hmhyau/EEE2037-FM-Radio-Project/Lab Project Report/Images/20170413_160736.jpg

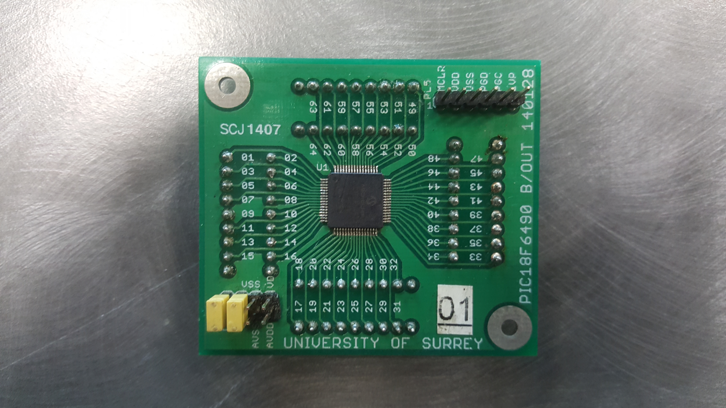
Lab Project Report/Images/20170413_160736.jpg
