hmhyau/EEE2037-FM-Radio-Project/README.md

# EEE2037-FM-Radio-Project
FM Radio Project code and report archives.
