hmhyau/EEE2037-FM-Radio-Project/Lab Project Report/Presentation.pptx

## LDPS IV FM Receiver Project

PENG YOUN TAN
TEDDY NG
HERMAN YAU

## Gantt Chart

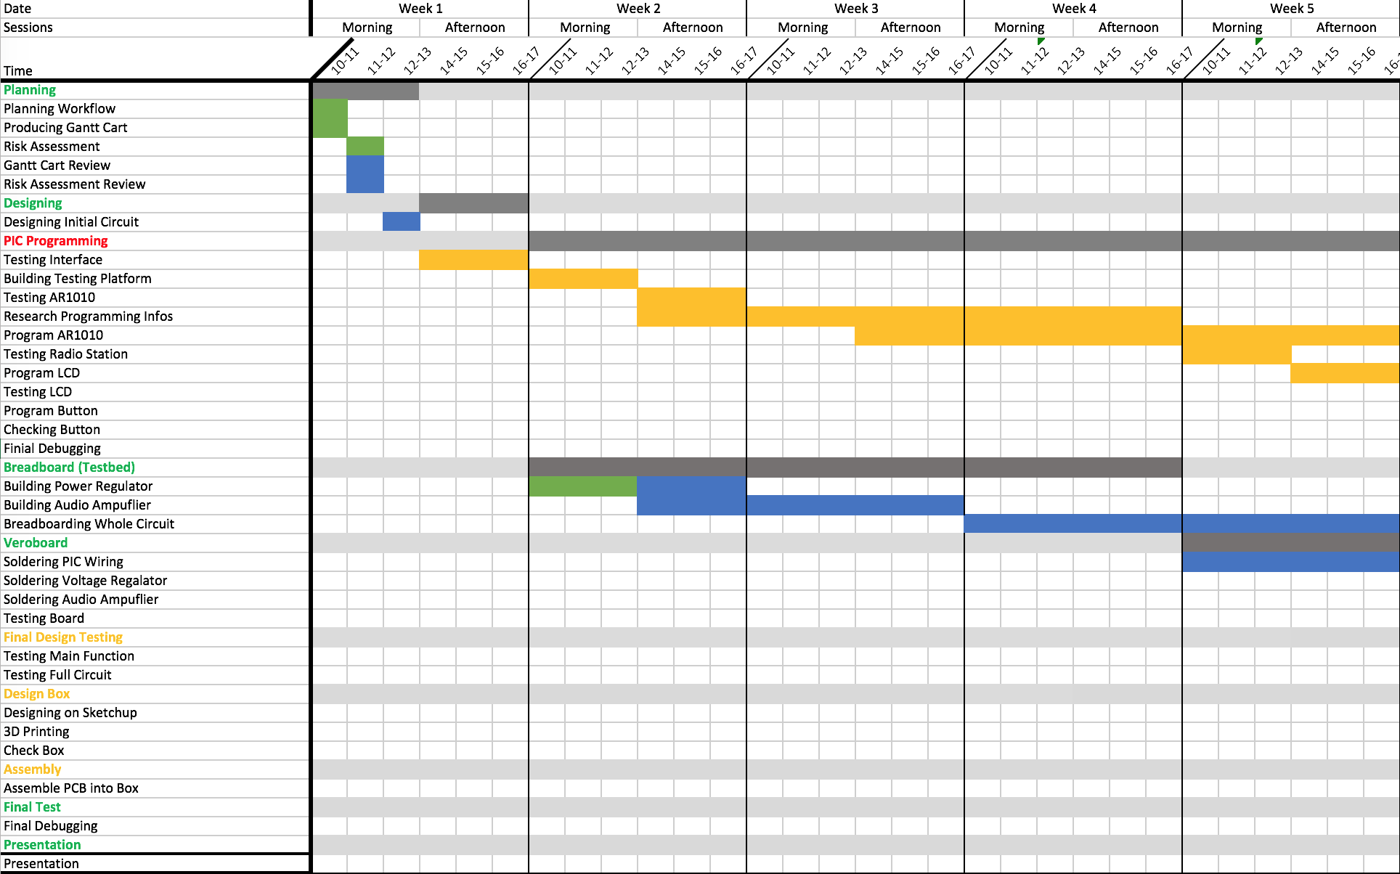
[picture p21: figure]

## Gantt Chart (cont’d)


## Specification (Hardware)

- 3 x 1.5V AA batteries Matrix Board Implementation Multiple output options: TRS jack socket output Built-in stereo speaker output

## Specification (Software)

- Channel switching: Manual tune Auto tune 4 preset frequencies Frequency Range: 87.5MHz -108 MHz Frequency and volume display Volume change functionality

## Hardware

- Power Block: Regulates voltage supply
- Amplifier Block: Amplifies audio signal to audible level
- Microcontroller Block: Connects to FM Receiver chip and other misc. I/O

## Power Block

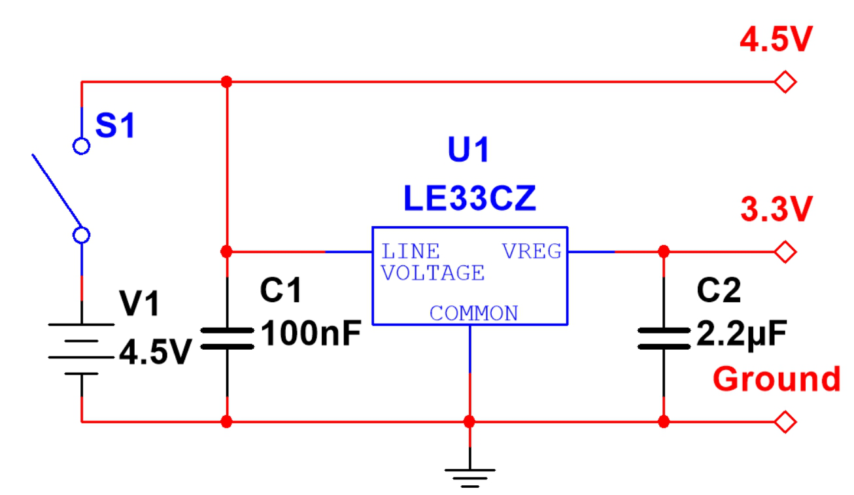
[picture p22: figure]

## Amplifier Block


## Microcontroller Block


## Microcontroller Block (cont’d)

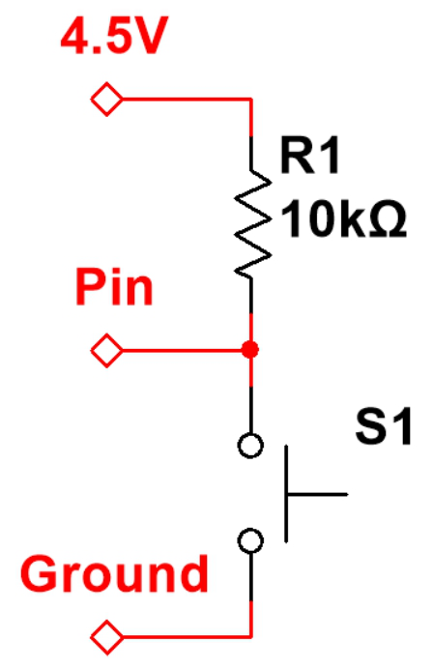
[picture p23: figure]

## Implementation of Enclosure

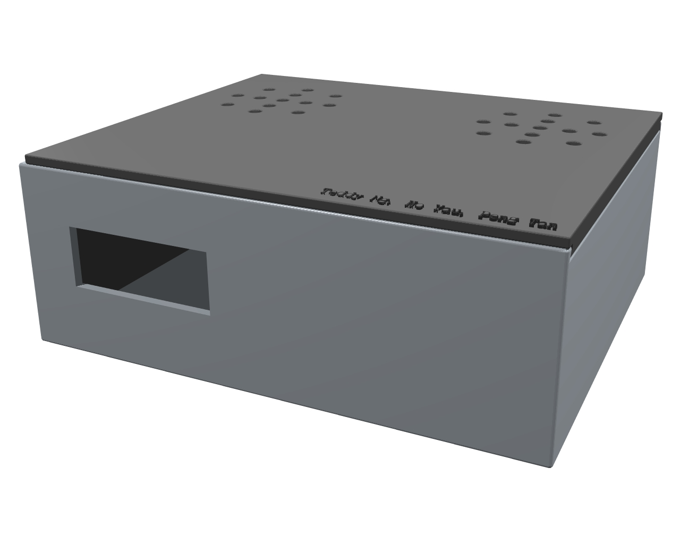
[picture p24: figure]

## Initial Research

- PIC18LF6490 Microcontroller  I²C Protocol, SCL and SDA buses only  Seven-segment Display Programming  Pushbuttons Programming

## Development Platform

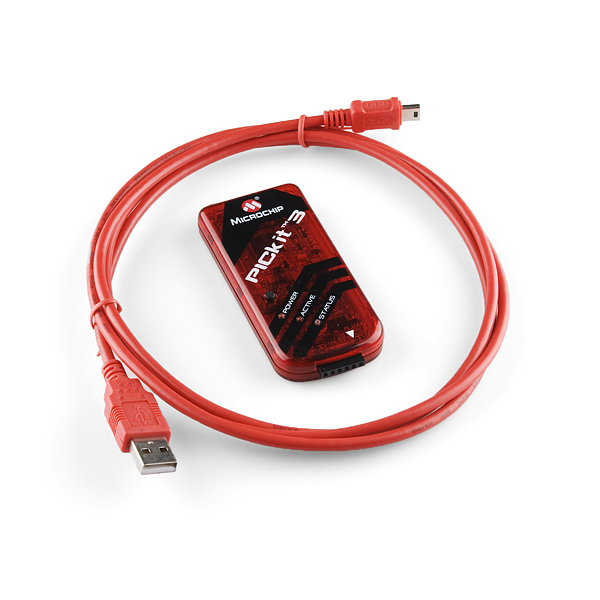
[picture p25: figure]

## Incremental Model


## Future Improvements

Implementation of Power-Managed Operation
Implementation of Tone Control

## Slide 16

Thank you for your time!
Any questions?
