hmhyau/EEE2037-FM-Radio-Project/Lab Project Report/Images/20170510_173029.jpg

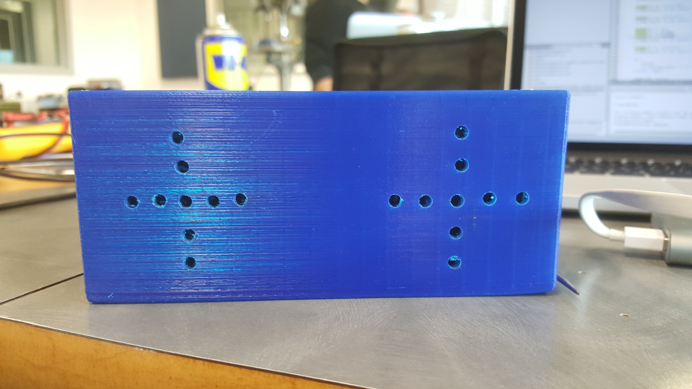
Lab Project Report/Images/20170510_173029.jpg
