hmhyau/EEE2037-FM-Radio-Project/Lab Project Report/regulator2.jpg

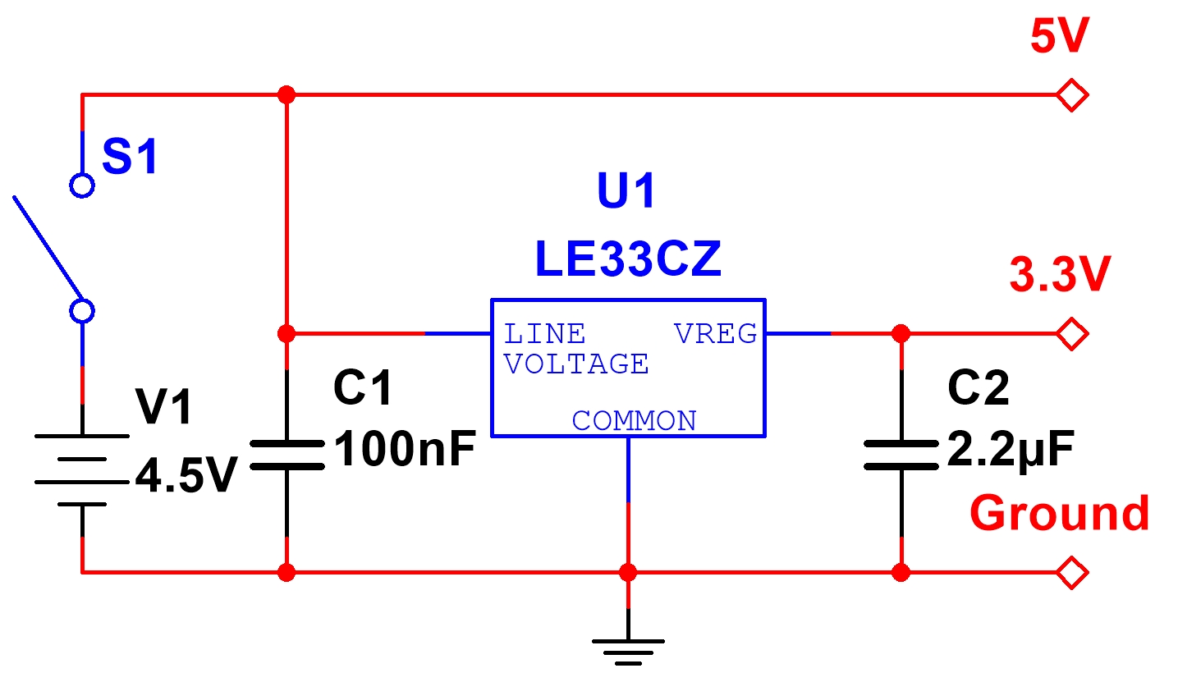
Lab Project Report/regulator2.jpg
