hmhyau/EEE2037-FM-Radio-Project/(list of files, cad)

Other CAD files:
Final Code/skel.X/dist/default/production/skel.X.production.obj
Final Code/skel.X/l.obj
