hmhyau/EEE2037-FM-Radio-Project/References/Volume_control_guide.png

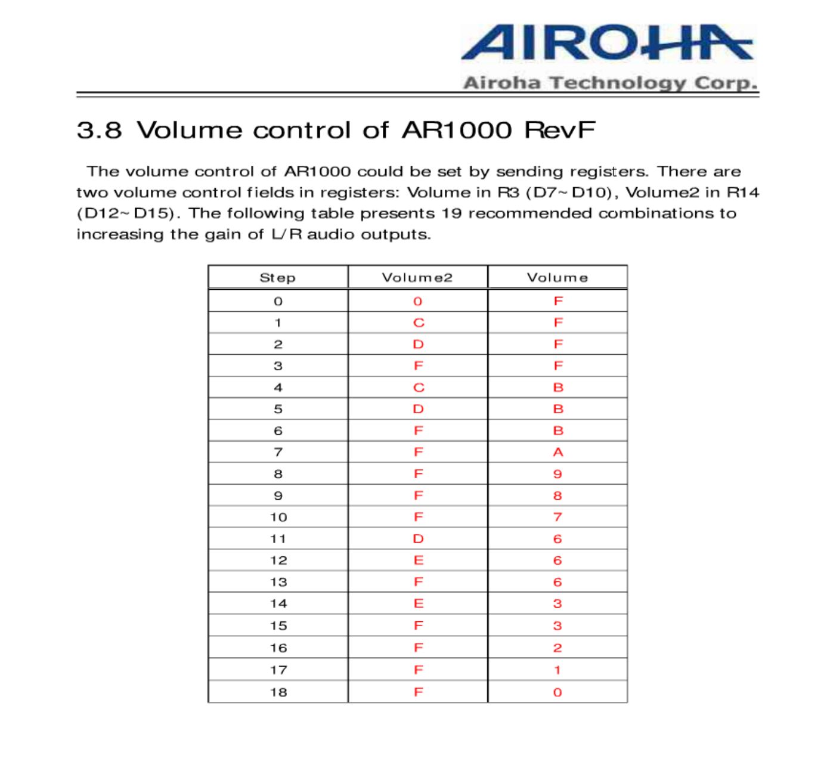
References/Volume_control_guide.png
