hmhyau/EEE2037-FM-Radio-Project/Lab Project Report/figs.pdf

## Fig. 1: TQFP adaptor board overlay

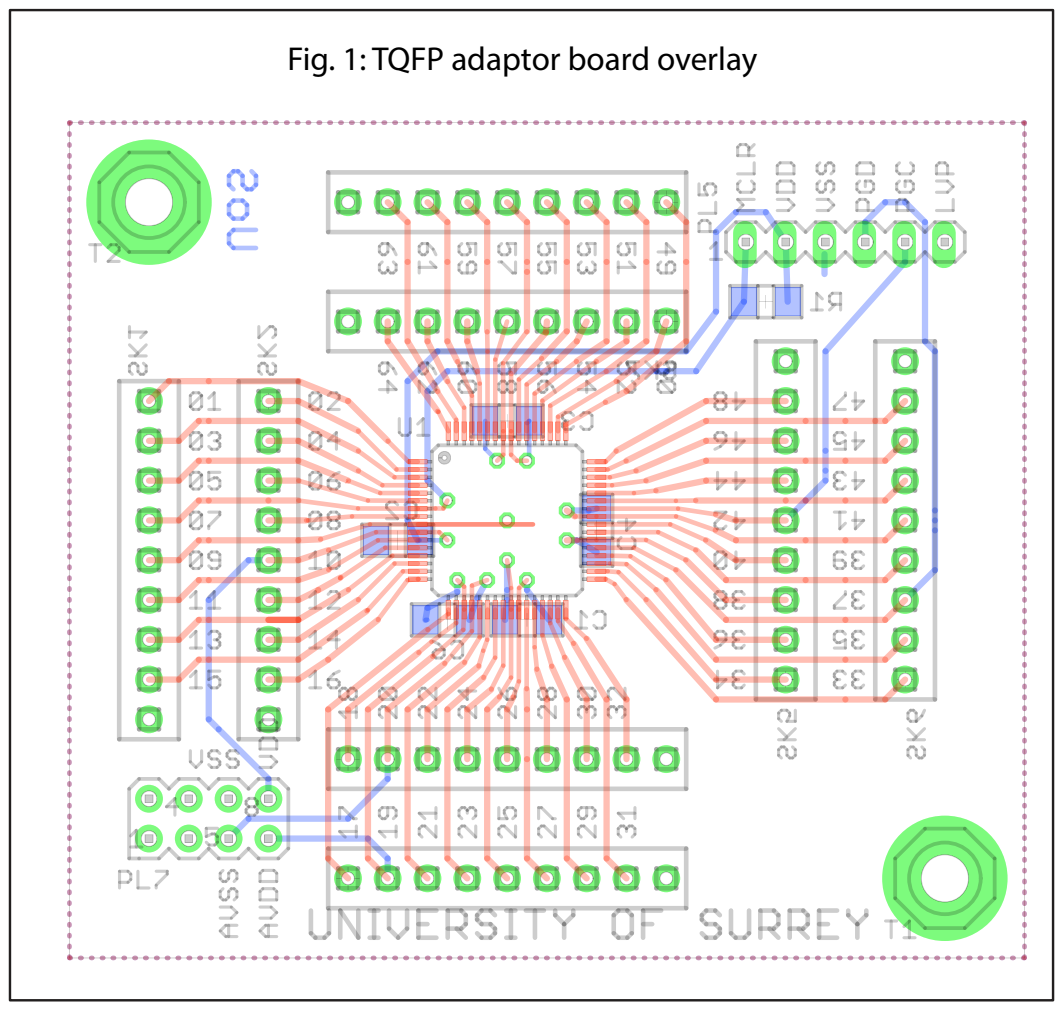
[picture p47: page 1]

## Fig. 2: Connecting the debugger

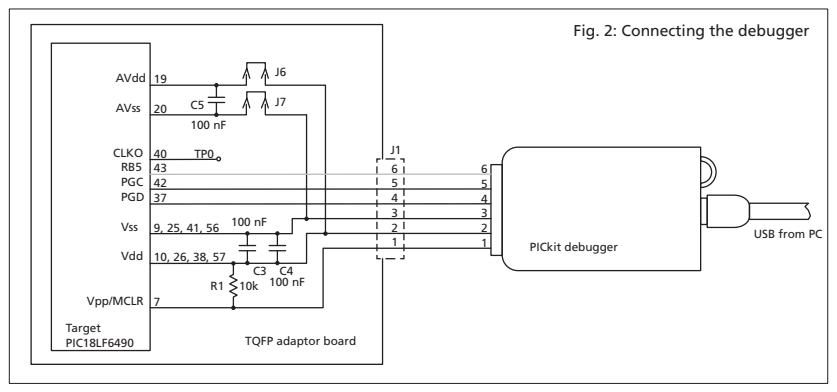
[picture p48: page 2]

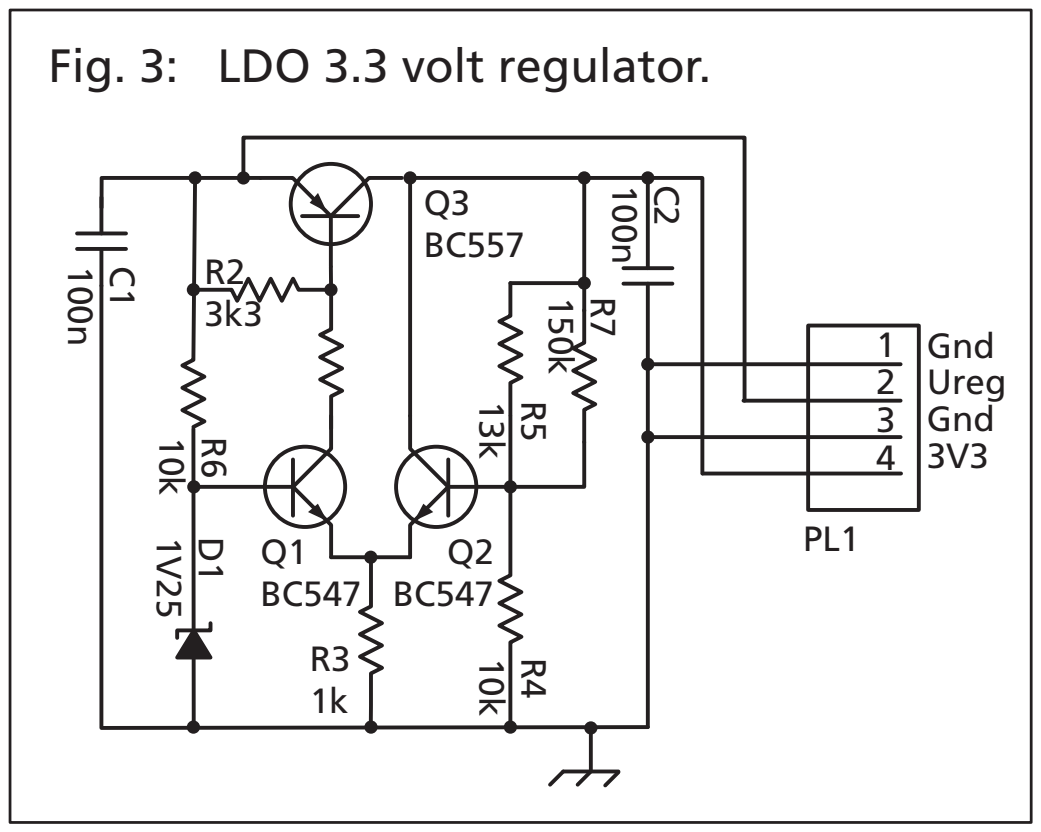
[picture p49: page 3]

Fig. 3: LDO 3.3 volt regulator.

## Fig. 4: Connecting the LCD module 64 LCDbias3

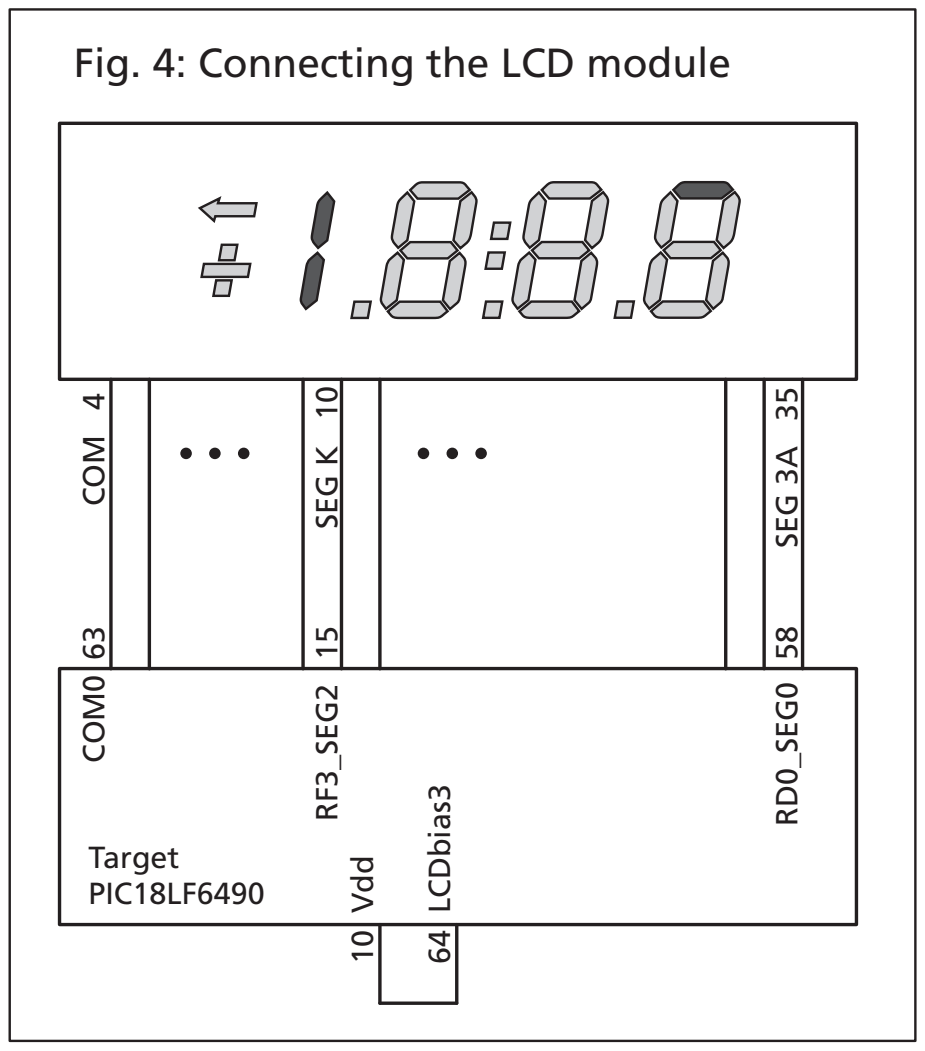
[picture p50: page 4]
Target PIC18LF6490; SEG 3A 35; SEG K 10; COM 4 COM0 63; RF3_SEG2 15; 10 Vdd; RD0_SEG0 58

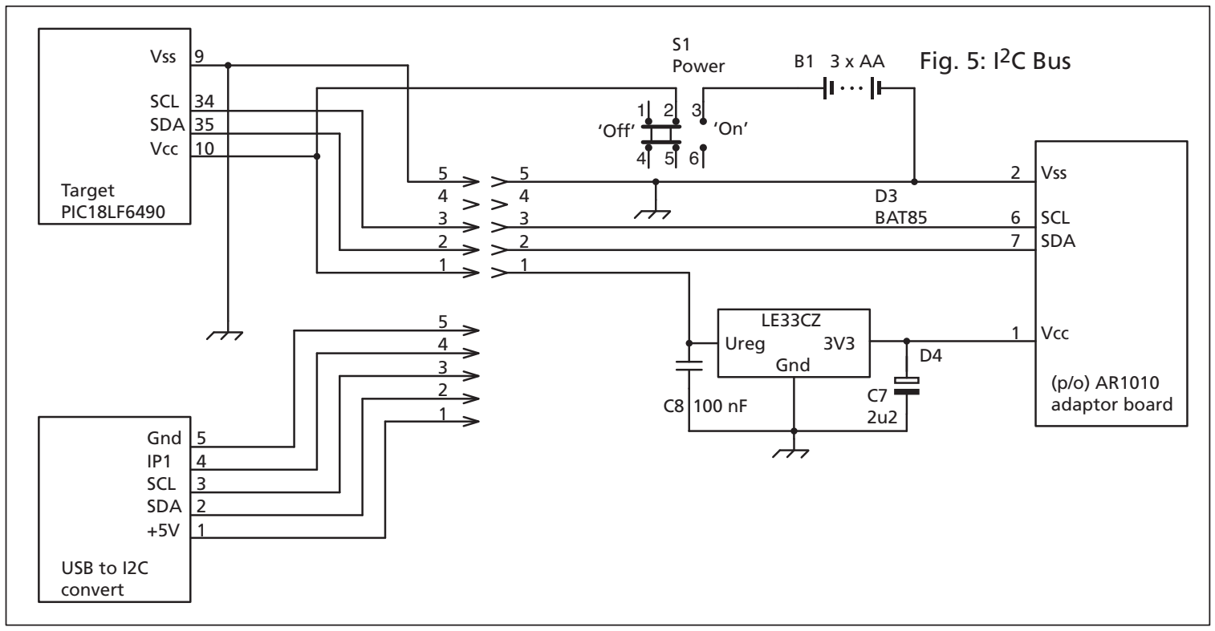
[picture p51: figure]
Target PIC18LF6490; USB to I2C convert; D3 BAT85; Vcc Ureg; Gnd; (p/o) AR1010 adaptor board; Fig. 5: I; 2C Bus; 7 SDA; 6 SCL; 2 Vss; 10Vcc; 35SDA; 34SCL; 9Vss; SDA; SCL; Gnd IP1; ‘Off’; Power
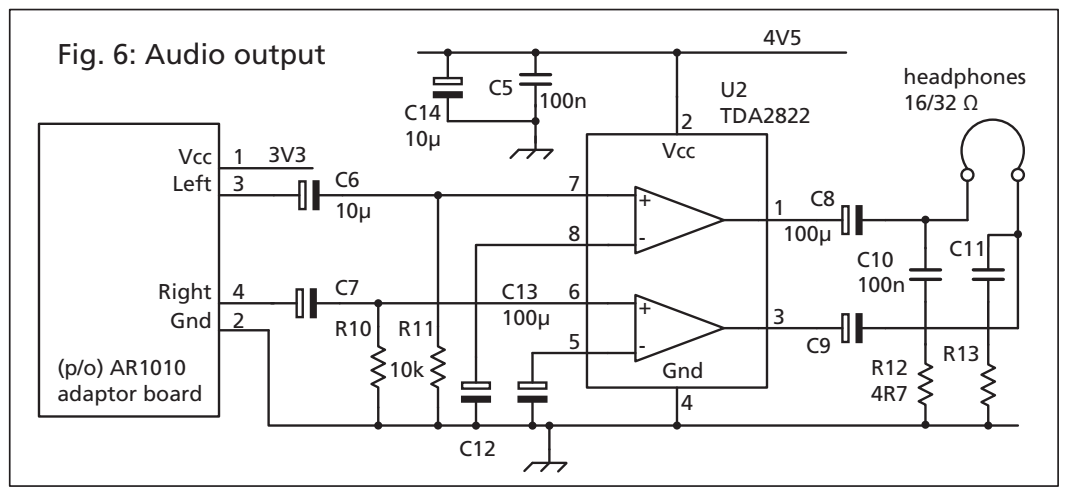
[picture p52: page 6]

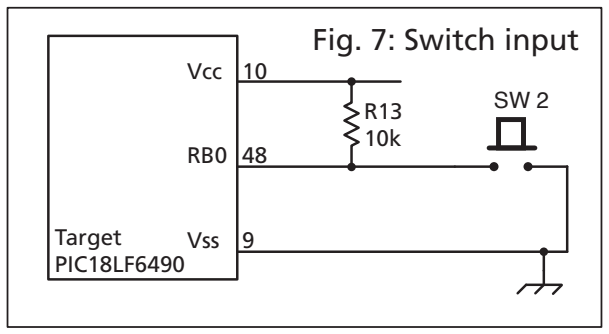
[picture p53: figure]
Target PIC18LF6490; Vcc; Vss; Fig. 7: Switch input
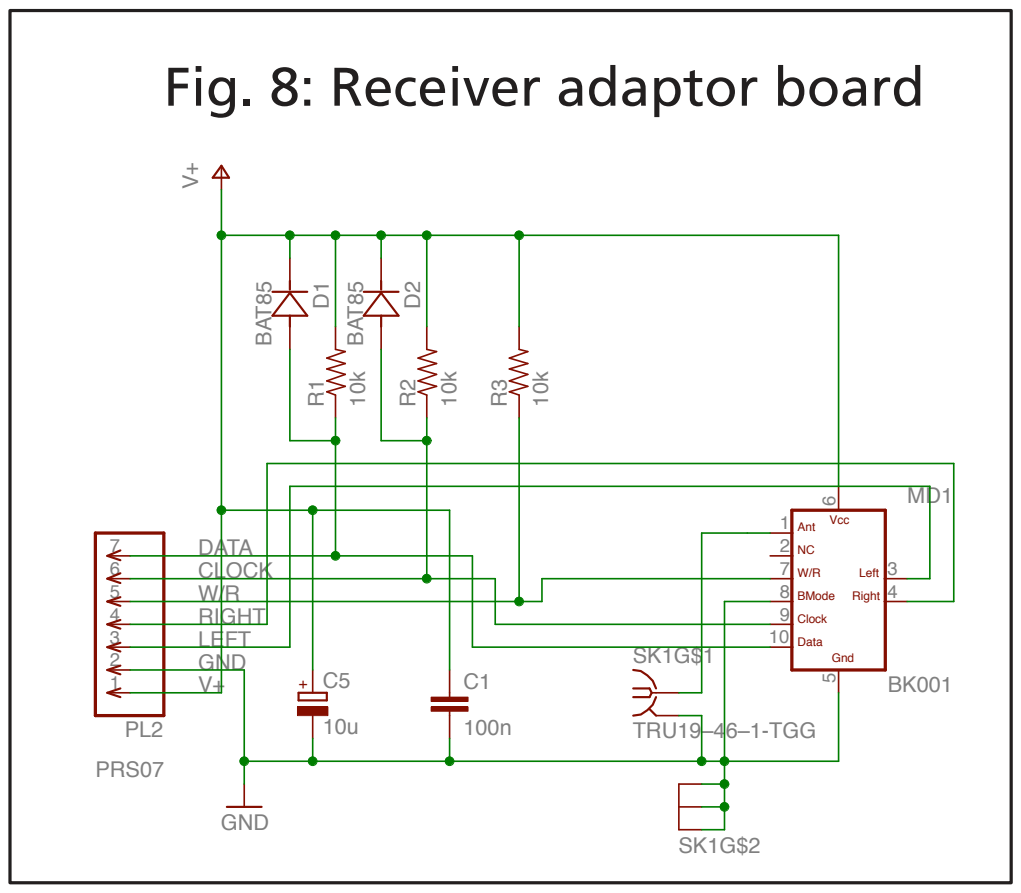
[picture p54: page 8]
10u ¹⁰k; GND; PRS07; TRU19–46–1-TGG; BAT85; C1 GND; DATA CLOCK W/R LEFT; RIGHT; Left Right; Ant; W/R BMode Clock Data; Vcc; Gnd

Fig. 8: Receiver adaptor board

3 | | 10
1 | V+
