hmhyau/EEE2037-FM-Radio-Project/Lab Project Report/FM Project.sch

## EAGLE design Lab Project Report/FM Project.sch (2018-08-14)

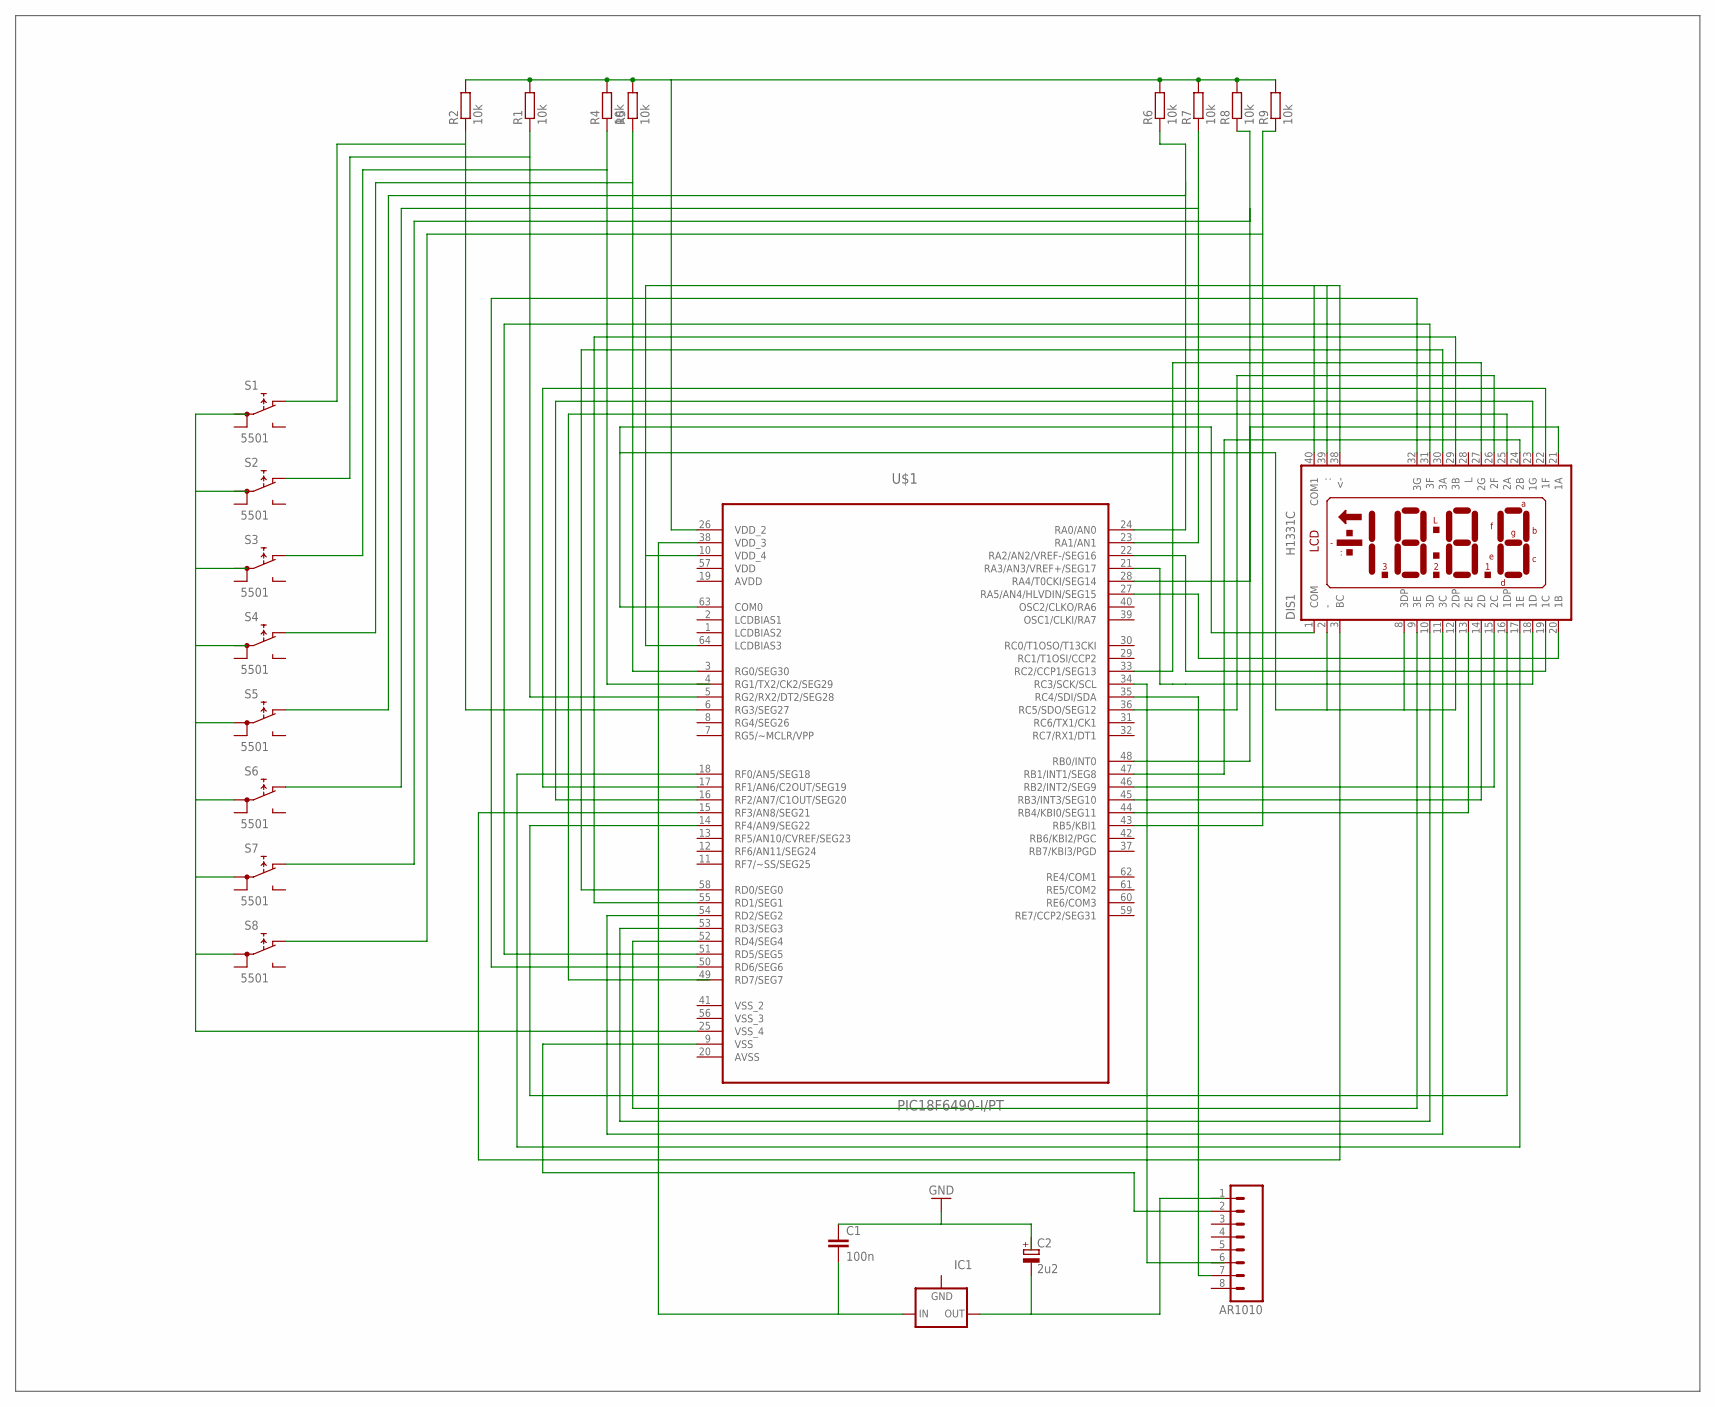
[picture p55: schematic FM Project.sch]

Parts:
AR1010: M08; 08P
C1: 100n; C5B3
C2: 2u2; 140CLH-0810
DIS1: H1331C
IC1: 79LXX
R1, R2, R4, R5, R6, R7, R8, R9: 10k; R0201
S1, S2, S3, S4, S5, S6, S7, S8: 5501
U$1: PIC18F6490-I/PT; QFP50P1200X1200X120-64N

Connections:
GND: C1.1
unnamed: DIS1.1 (COM), DIS1.2 (-), DIS1.8 (3DP), DIS1.12 (2DP), U$1.63 (COM0)
unnamed: DIS1.38 (<-), DIS1.39 (:), DIS1.40 (COM1), U$1.10 (VDD_4), U$1.64 (LCDBIAS3)
unnamed: DIS1.21 (1A), U$1.28 (RA4/T0CKI/SEG14)
unnamed: DIS1.20 (1B), U$1.27 (RA5/AN4/HLVDIN/SEG15)
unnamed: DIS1.19 (1C), U$1.22 (RA2/AN2/VREF-/SEG16)
unnamed: DIS1.27 (2G), U$1.33 (RC2/CCP1/SEG13)
unnamed: DIS1.17 (1E), U$1.18 (RF0/AN5/SEG18)
unnamed: DIS1.22 (1F), U$1.17 (RF1/AN6/C2OUT/SEG19)
unnamed: DIS1.23 (1G), U$1.16 (RF2/AN7/C1OUT/SEG20)
unnamed: DIS1.18 (1D), U$1.21 (RA3/AN3/VREF+/SEG17)
unnamed: DIS1.24 (2B), U$1.47 (RB1/INT1/SEG8)
unnamed: DIS1.15 (2C), U$1.46 (RB2/INT2/SEG9)
unnamed: DIS1.14 (2D), U$1.45 (RB3/INT3/SEG10)
unnamed: DIS1.13 (2E), U$1.44 (RB4/KBI0/SEG11)
unnamed: DIS1.26 (2F), U$1.36 (RC5/SDO/SEG12)
unnamed: DIS1.30 (3A), U$1.58 (RD0/SEG0)
unnamed: DIS1.29 (3B), U$1.55 (RD1/SEG1)
unnamed: DIS1.11 (3C), U$1.54 (RD2/SEG2)
unnamed: DIS1.10 (3D), U$1.53 (RD3/SEG3)
unnamed: DIS1.9 (3E), U$1.52 (RD4/SEG4)
unnamed: DIS1.31 (3F), U$1.51 (RD5/SEG5)
unnamed: DIS1.32 (3G), U$1.50 (RD6/SEG6)
unnamed: DIS1.16 (1DP), U$1.14 (RF4/AN9/SEG22)
unnamed: DIS1.3 (BC), U$1.15 (RF3/AN8/SEG21)
unnamed: C1.2, IC1.IN, U$1.38 (VDD_3)
unnamed: AR1010.7, U$1.35 (RC4/SDI/SDA)
unnamed: R9.1, U$1.43 (RB5/KBI1)
unnamed: AR1010.2, U$1.9 (VSS)
unnamed: R8.1, U$1.48 (RB0/INT0)
unnamed: R6.1, U$1.24 (RA0/AN0)
unnamed: R1.1, U$1.5 (RG2/RX2/DT2/SEG28)
unnamed: R2.1, U$1.6 (RG3/SEG27)
unnamed: R1.2, R2.2, R4.2, R5.2, R6.2, R7.2, R8.2, R9.2, U$1.26 (VDD_2)
unnamed: S5.1A, S6.1A, S7.1A, S8.1A, U$1.25 (VSS_4)
